gigijoe/E-IKE/InstallationGuide.odt

Enhanced IKE Installation Guide

IKE : Instrument Cluster

Find connector X10113 on the back of IKE. Mark the following wires.

D-Bus : Pin 1 (White / Purple)

I-Bus : Pin 8 (White / Gray / Yellow)

12V : Pin 12 (Purple / Green)

GND : Pin 9 / 10 (Brown / White or Green)
