gigijoe/E-IKE/Hardware/stm32f103-ibus.sch

## KiCad design Hardware/stm32f103-ibus.sch (2020-05-14)

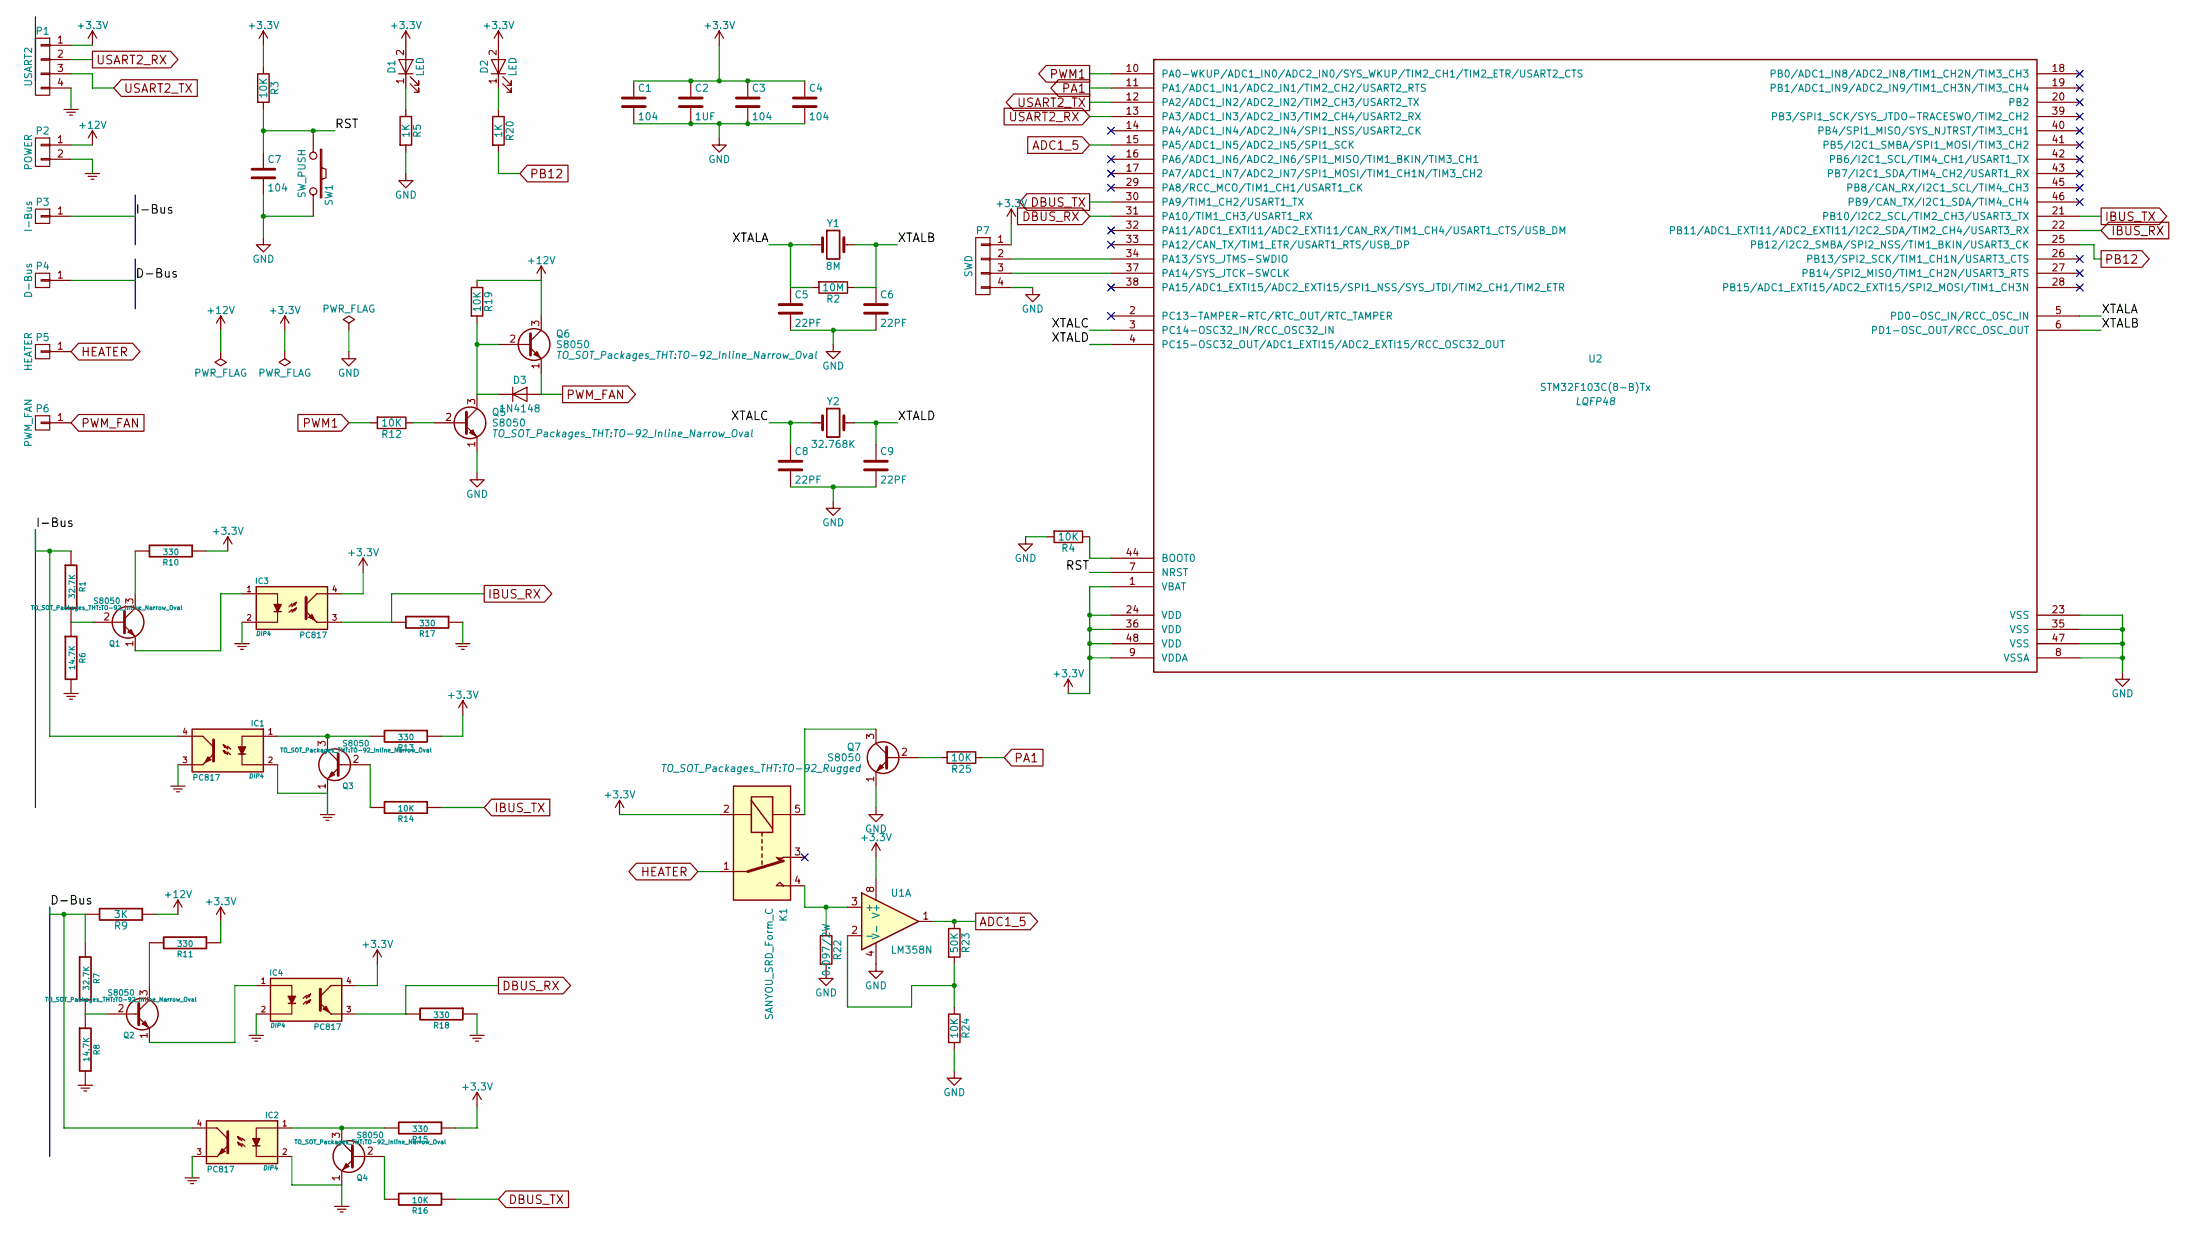
[picture p1: schematic stm32f103-ibus.sch]

Parts:
C1, C3, C4, C7: 104; C_1206_HandSoldering
C2: 1UF; C_1206_HandSoldering
C5, C6, C8, C9: 22PF; C_1206_HandSoldering
D1, D2: LED; LED_1206
D3: 1N4148; D_DO-35_SOD27_Horizontal_RM10
IC1, IC2, IC3, IC4: PC817; DIP4
K1: SANYOU_SRD_Form_C; Relay_SPDT_SANYOU_SRD_Series_Form_C
P1: USART2; Pin_Header_Straight_1x04
P2: POWER; Socket_Strip_Straight_1x02
P3: I-Bus; Pin_Header_Straight_1x01
P4: D-Bus; Pin_Header_Straight_1x01
P5: HEATER; Pin_Header_Straight_1x01
P6: PWM_FAN; Pin_Header_Straight_1x01
P7: SWD; Pin_Header_Straight_1x04
Q1, Q2, Q3, Q4, Q5, Q6: S8050; TO-92_Inline_Narrow_Oval
Q7: S8050; TO-92_Rugged
R1, R7: 32.7K; R3
R2: 10M; R_1206_HandSoldering
R3, R4: 10K; R_1206_HandSoldering
R5: 1K; R_1206_HandSoldering
R6, R8: 14.7K; R3
R9: 3K; R3
R10, R11, R13, R15, R17, R18: 330; R3
R12, R19, R24, R25: 10K; R_1206
R14, R16: 10K; R3
R20: 1K; R_1206
R22: 0.097/2W; R_1206
R23: 50K; R_1206
SW1: SW_PUSH; SW_SPST_FSMSM
U1: LM358N; DIP-8_W7.62mm
U2: STM32F103C(8-B)Tx; LQFP48
Y1: 8M; Crystal_SMD_0603_2Pads_obsolete
Y2: 32.768K; Crystal_HC49-U_Vertical

Connections:
+3.3V: C1.1, C2.1, C3.1, C4.1, D1.2 (A), D2.2 (A), IC3.4, IC4.4, K1.2, P1.1, P7.1, R3.1, R10.1, R11.1, R13.1, R15.1, U1.8 (V+), U2.1 (VBAT), U2.9 (VDDA), U2.24 (VDD), U2.36 (VDD), U2.48 (VDD)
+12V: P2.1, Q6.3 (C), R9.1, R19.1
ADC1_5: R23.1, U1.1, U2.15 (PA5/ADC1_IN5/ADC2_IN5/SPI1_SCK)
D-Bus: IC2.4, P4.1, R7.1, R9.2
DBUS_RX: IC4.3, R18.2, U2.31 (PA10/TIM1_CH3/USART1_RX)
DBUS_TX: R16.1, U2.30 (PA9/TIM1_CH2/USART1_TX)
GND: C1.2, C2.2, C3.2, C4.2, C5.2, C6.2, C7.2, C8.2, C9.2, IC1.2, IC1.3, IC2.2, IC2.3, IC3.2, IC4.2, P1.4, P2.2, P7.4, Q3.1 (E), Q4.1 (E), Q5.1 (E), Q7.1 (E), R4.2, R5.2, R6.2, R8.2, R17.1, R18.1, R22.2, R24.2, SW1.2, U1.4 (V-), U2.8 (VSSA), U2.23 (VSS), U2.35 (VSS), U2.47 (VSS)
HEATER: K1.1, P5.1
I-Bus: IC1.4, P3.1, R1.1
IBUS_RX: IC3.3, R17.2, U2.22 (PB11/ADC1_EXTI11/ADC2_EXTI11/I2C2_SDA/T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)
IBUS_TX: R14.1, U2.21 (PB10/I2C2_SCL/TIM2_CH3/USART3_TX)
unnamed: D1.1 (K), R5.1
unnamed: D2.1 (K), R20.1
unnamed: D3.1 (K), Q5.3 (C), Q6.2 (B), R19.2
unnamed: IC1.1, Q3.3 (C), R13.2
unnamed: IC2.1, Q4.3 (C), R15.2
unnamed: IC3.1, Q1.1 (E)
unnamed: IC4.1, Q2.1 (E)
unnamed: K1.4, R22.1, U1.3 (+)
unnamed: K1.5, Q7.3 (C)
unnamed: P7.2, U2.34 (PA13/SYS_JTMS-SWDIO)
unnamed: P7.3, U2.37 (PA14/SYS_JTCK-SWCLK)
unnamed: Q1.2 (B), R1.2, R6.1
unnamed: Q1.3 (C), R10.2
unnamed: Q2.2 (B), R7.2, R8.1
unnamed: Q2.3 (C), R11.2
unnamed: Q3.2 (B), R14.2
unnamed: Q4.2 (B), R16.2
unnamed: Q5.2 (B), R12.1
unnamed: Q7.2 (B), R25.2
unnamed: R4.1, U2.44 (BOOT0)
unnamed: R23.2, R24.1, U1.2 (-)
PA1: R25.1, U2.11 (PA1/ADC1_IN1/ADC2_IN1/TIM2_CH2/USART2_R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)
PB12: R20.2, U2.25 (PB12/I2C2_SMBA/SPI2_NSS/TIM1_BKIN/USART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)
PWM1: R12.2, U2.10 (PA0-WKUP/ADC1_IN0/ADC2_IN0/SYS_WKUP/TIM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)
PWM_FAN: D3.2 (A), P6.1, Q6.1 (E)
RST: C7.1, R3.2, SW1.1, U2.7 (NRST)
USART2_RX: P1.2, U2.13 (PA3/ADC1_IN3/ADC2_IN3/TIM2_CH4/USART2_RX)
USART2_TX: P1.3, U2.12 (PA2/ADC1_IN2/ADC2_IN2/TIM2_CH3/USART2_TX)
XTALA: C5.1, R2.2, U2.5 (PD0-OSC_IN/RCC_OSC_IN), Y1.1
XTALB: C6.1, R2.1, U2.6 (PD1-OSC_OUT/RCC_OSC_OUT), Y1.2
XTALC: C8.1, U2.3 (PC14-OSC32_IN/RCC_OSC32_IN), Y2.1
XTALD: C9.1, U2.4 (PC15-OSC32_OUT/ADC1_EXTI15/ADC2_EXTI15/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), Y2.2
