gigijoe/E-IKE/(commit log)

2018-04-25 Initialize E-IKE
    [stm32f103-ibus.sch]
2019-03-04 Various update 1.Optimization of compiler options 2.Supports internal flash read / write 3.Supports 1999 model
    [stm32f103-ibus.sch]
2020-05-14 1.Modift Makefile to reduce binary size 2.Display both coolant temperature and coolant out temperature
2020-06-01 Fix bugs of Smoothness display
    [main.c]
